IowaScaledEngineering/i2c-headunit/pg/i2c-headunit-v1.1-6b61e0d/i2c-headunit.pdf

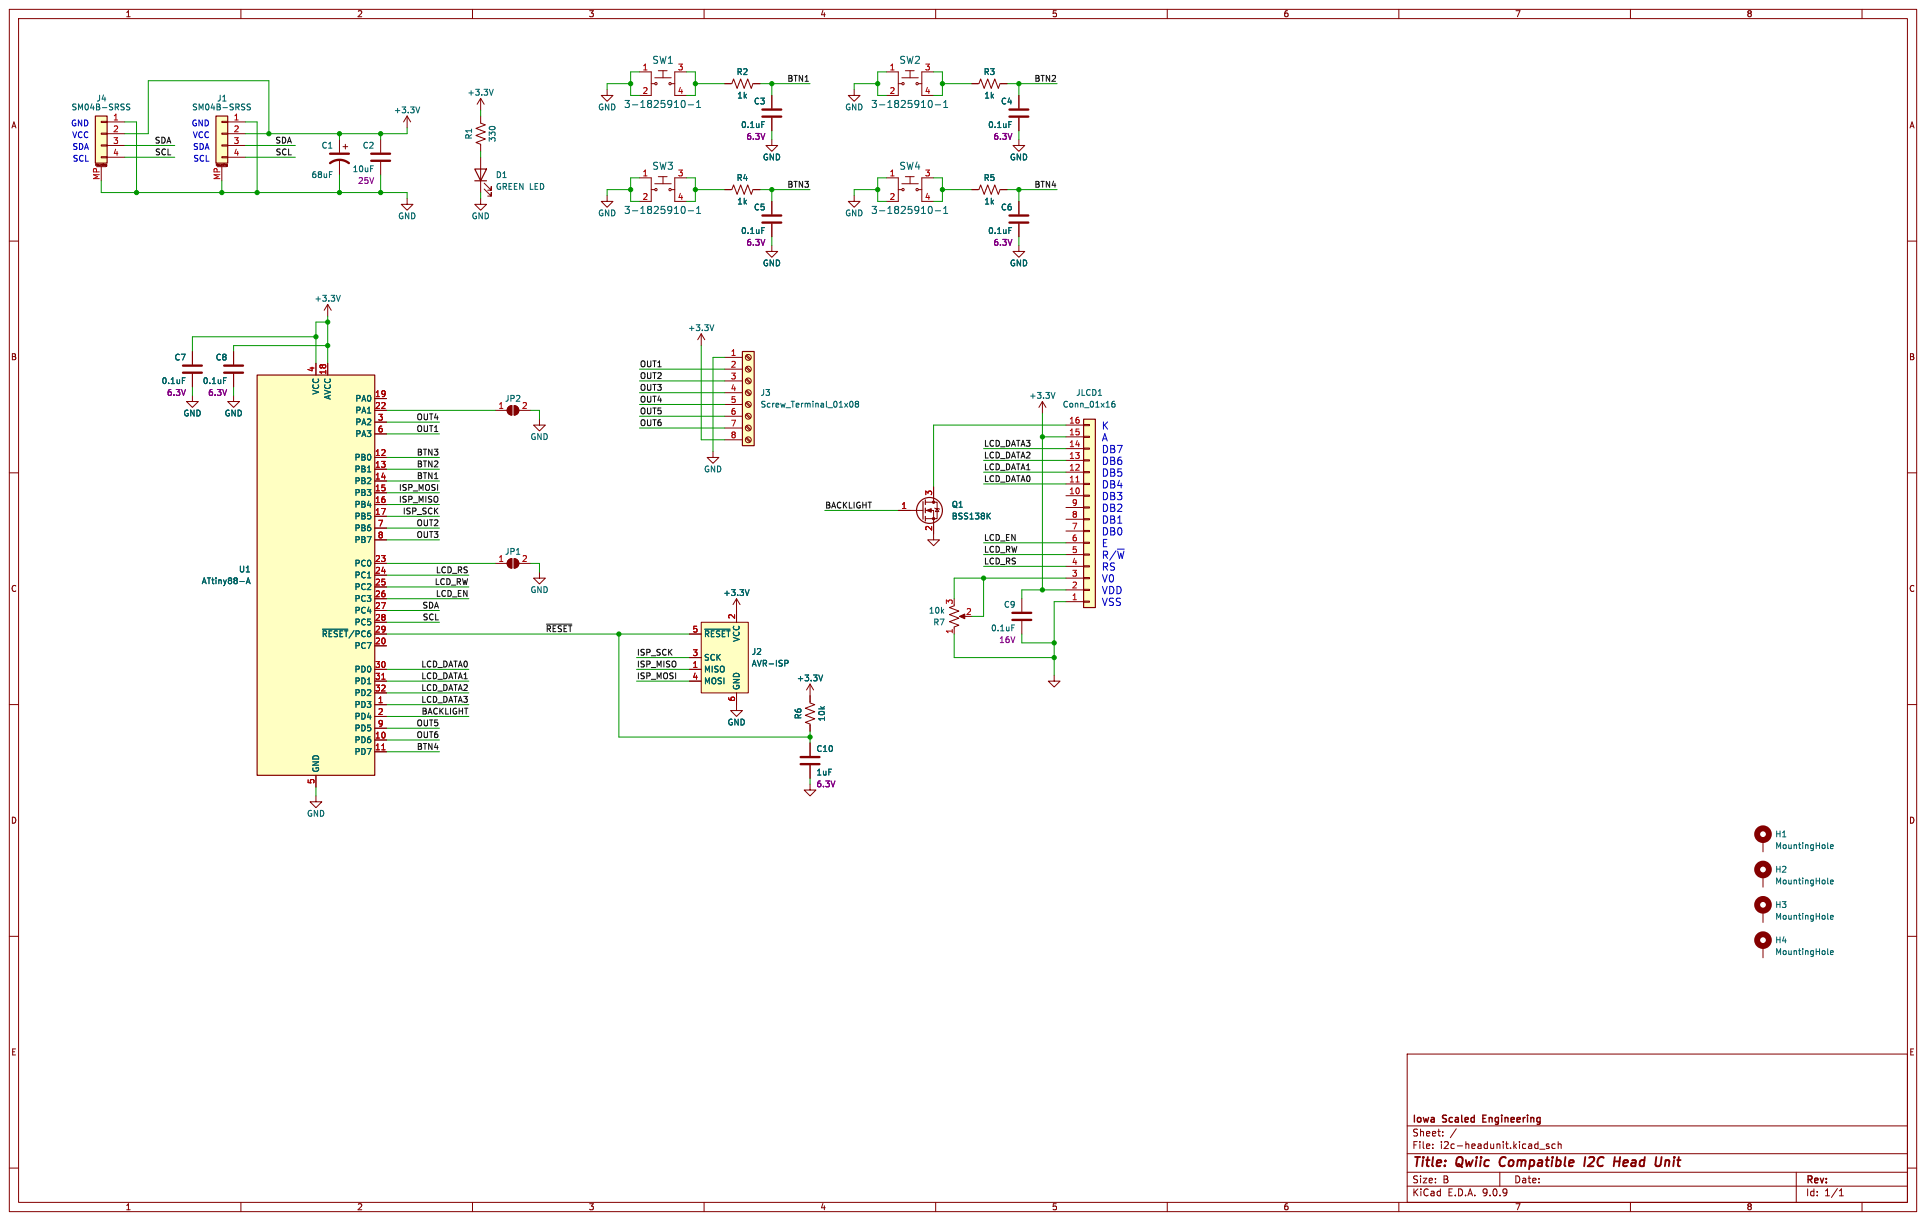
[picture p1: page 1]

6 ~{RESET} 5 SCK 3 MISO 1 MOSI 4

6 ~{RESET} 5 SCK 3 MISO 1 MOSI 4 GND

Id: 1/1 Title: Qwiic Compatible I2C Head Unit File: i2c-headunit.kicad_sch Sheet: /
