IowaScaledEngineering/i2c-headunit/pg/i2c-headunit-v1.0-bc90d93/i2c-headunit.pdf

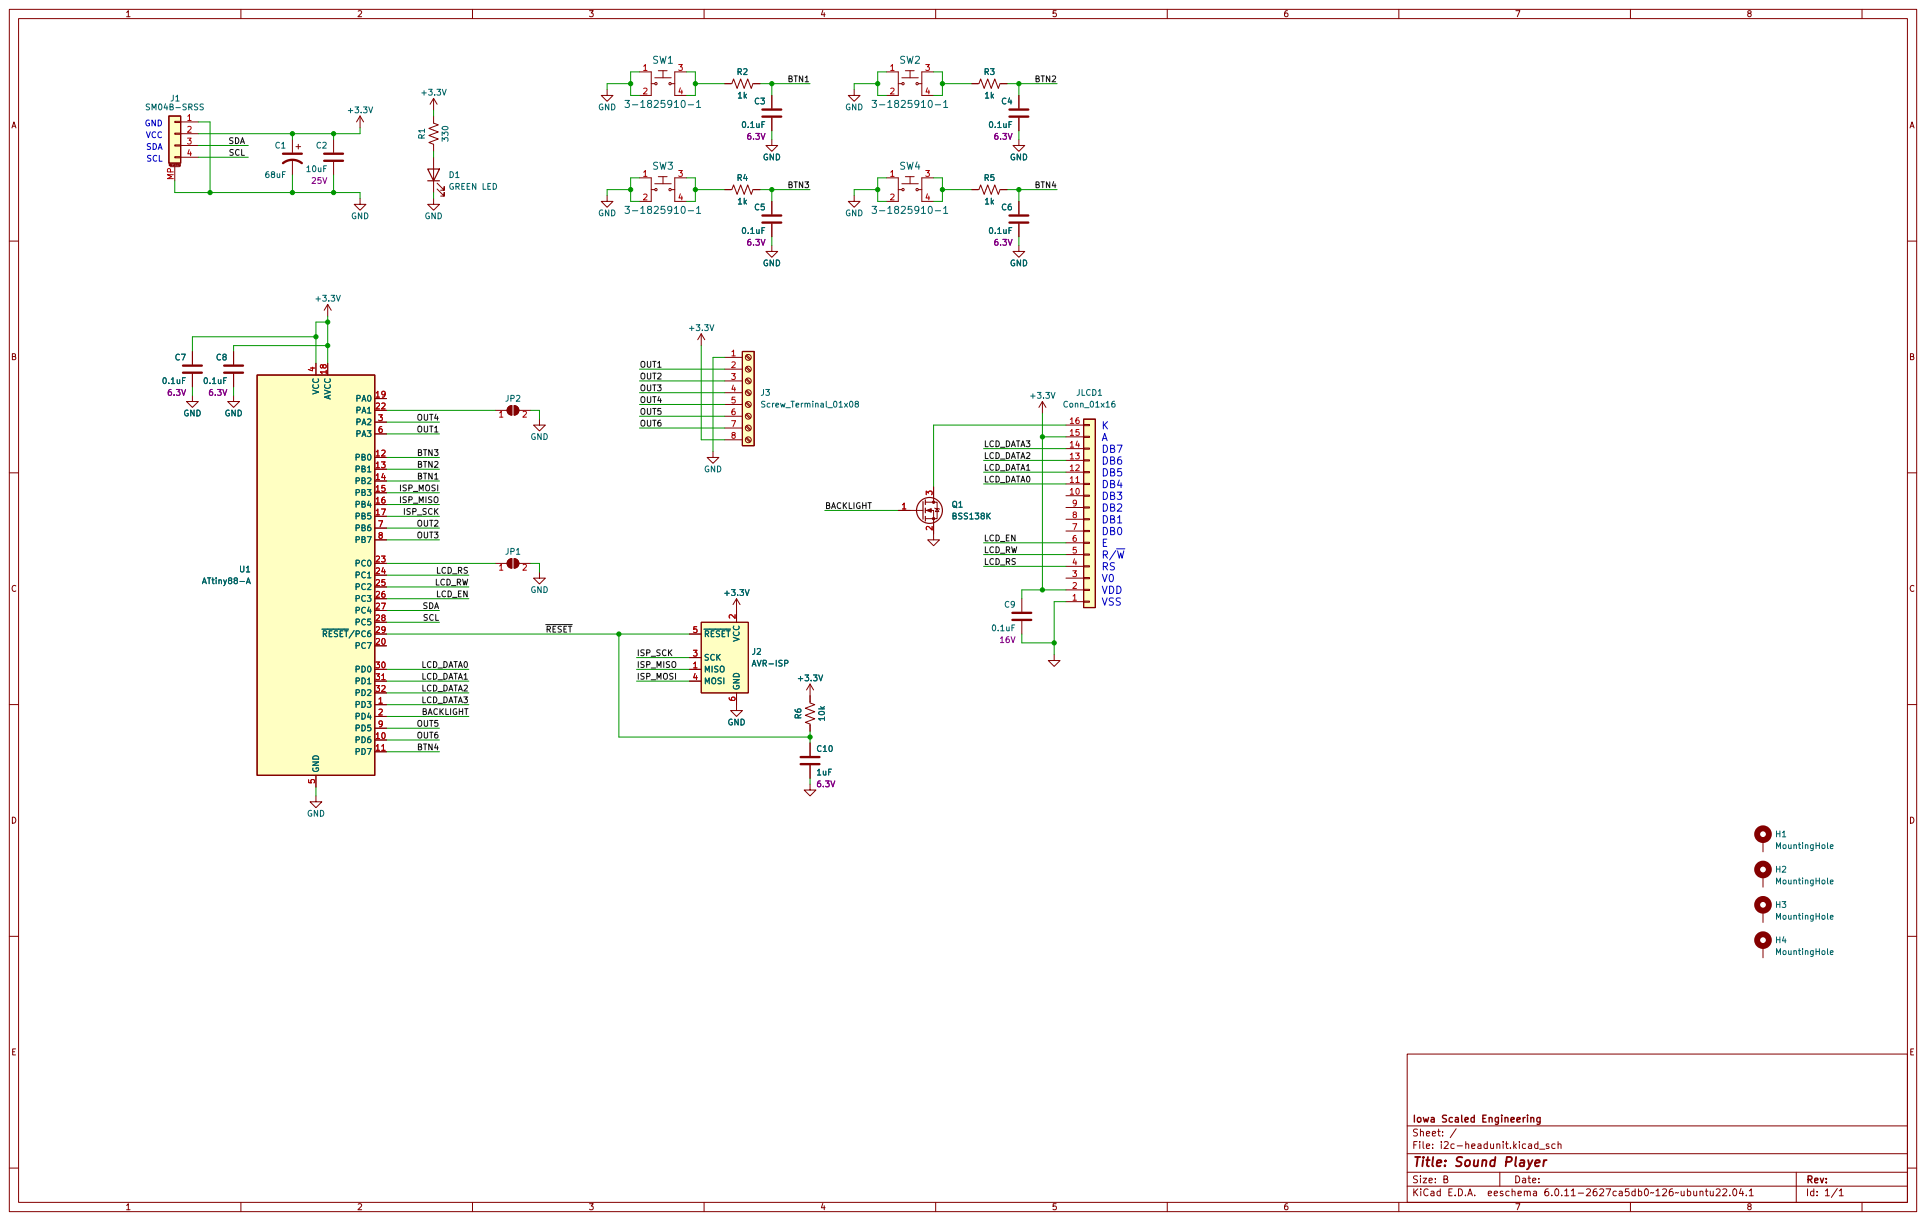
[picture p2: page 1]

2 SCK 3 MOSI 4 ~{RESET} 5 GND

Id: 1/1 Title: Sound Player File: i2c-headunit.kicad_sch Sheet: /
