IowaScaledEngineering/i2c-headunit/src/avr-ringbuffer.h

/*************************************************************************
Title:    AVR Ringbuffer
Authors:  Mark Finn <mark@mfinn.net>, Green Bay, WI, USA
          Nathan Holmes <maverick@drgw.net>, Colorado, USA
File:     avr-ringbuffer.h
License:  GNU General Public License v3

LICENSE:
    Copyright (C) 2014 Mark Finn, Nathan Holmes

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
*************************************************************************/

#ifndef _AVR_RINGBUFFER_H_
#define _AVR_RINGBUFFER_H_

#ifndef RING_BUFFER_SZ
#define RING_BUFFER_SZ  32
#endif

#include <util/atomic.h>

typedef struct
{
	volatile uint8_t headIdx;
	volatile uint8_t len;	
	volatile uint8_t bufferData[RING_BUFFER_SZ];
} RingBuffer;


void ringBufferInitialize(RingBuffer* r);
uint8_t ringBufferDepth(RingBuffer* r);
uint8_t ringBufferPushNonBlocking(RingBuffer* r, uint8_t data);
void ringBufferPushBlocking(RingBuffer* r, uint8_t data);
uint8_t ringBufferPopNonBlocking(RingBuffer* r);
uint8_t ringBufferPopBlocking(RingBuffer* r);

#endif
