IowaScaledEngineering/i2c-headunit/(commit log)

2025-05-12 Some initial routing
    [i2c-headunit.kicad_pcb]
2025-05-12 Fixed I2C pins and more routing
    [i2c-headunit.kicad_pcb, i2c-headunit.kicad_sch]
2025-05-12 Completed wiring
    [i2c-headunit.kicad_pcb, i2c-headunit.kicad_sch]
2025-05-12 Added terminal block
    [i2c-headunit.kicad_pcb, i2c-headunit.kicad_sch]
2025-05-13 Added terminal block and solder jumpers
    [i2c-headunit.kicad_pcb, i2c-headunit.kicad_sch]
2025-05-14 Cleaned up tracks
    [i2c-headunit.kicad_pcb]
2025-05-18 Sent to fab
    [i2c-headunit-NPTH.drl, i2c-headunit.drl, i2c-headunit.gbl, i2c-headunit.gbo, i2c-headunit.gbp, i2c-headunit.gbr, i2c-headunit.gbs, i2c-headunit.gm1]
2025-06-03 Added second Qwiic connector
    [i2c-headunit.kicad_pcb, i2c-headunit.kicad_sch]
2025-08-10 Add a burning trashheap of a first cut at source code
    [avr-ringbuffer.c, avr-ringbuffer.h, i2c-headunit.c, i2c-rx.c, i2c-rx.h]
2026-05-23 Set additional bits on recovery from bus error
    [i2c-rx.c]
2026-05-25 Added contrast pot
    [i2c-headunit.kicad_pcb, i2c-headunit.kicad_sch]
2026-05-29 Removed metal under potentiometer
    [i2c-headunit.kicad_pcb]
2026-06-19 PG 1.1
    [i2c-headunit-NPTH.drl, i2c-headunit.drl, i2c-headunit.gbl, i2c-headunit.gbo, i2c-headunit.gbp, i2c-headunit.gbr, i2c-headunit.gbs, i2c-headunit.gm1]
