IowaScaledEngineering/i2c-headunit/(notices)

Notices in the files:
kicad/i2c-headunit/i2c-headunit.kicad_pcb:
©2025 CC BY-SA
